growthlayer/pinball-arcade-controller/docs/cover_placement.png

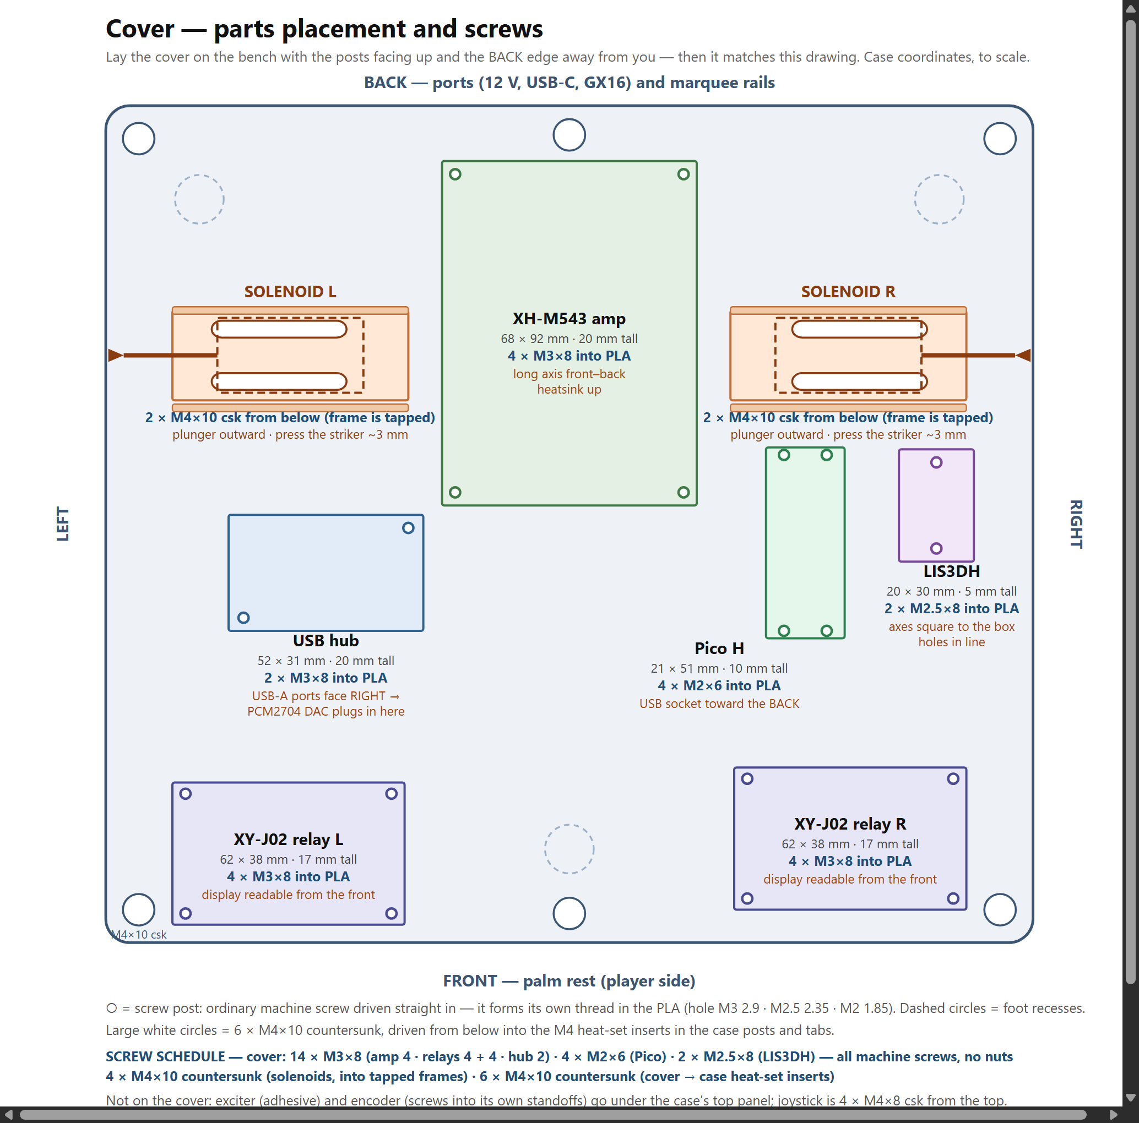
docs/cover_placement.png
