growthlayer/pinball-arcade-controller/docs/gx16_face_key_bottom.png

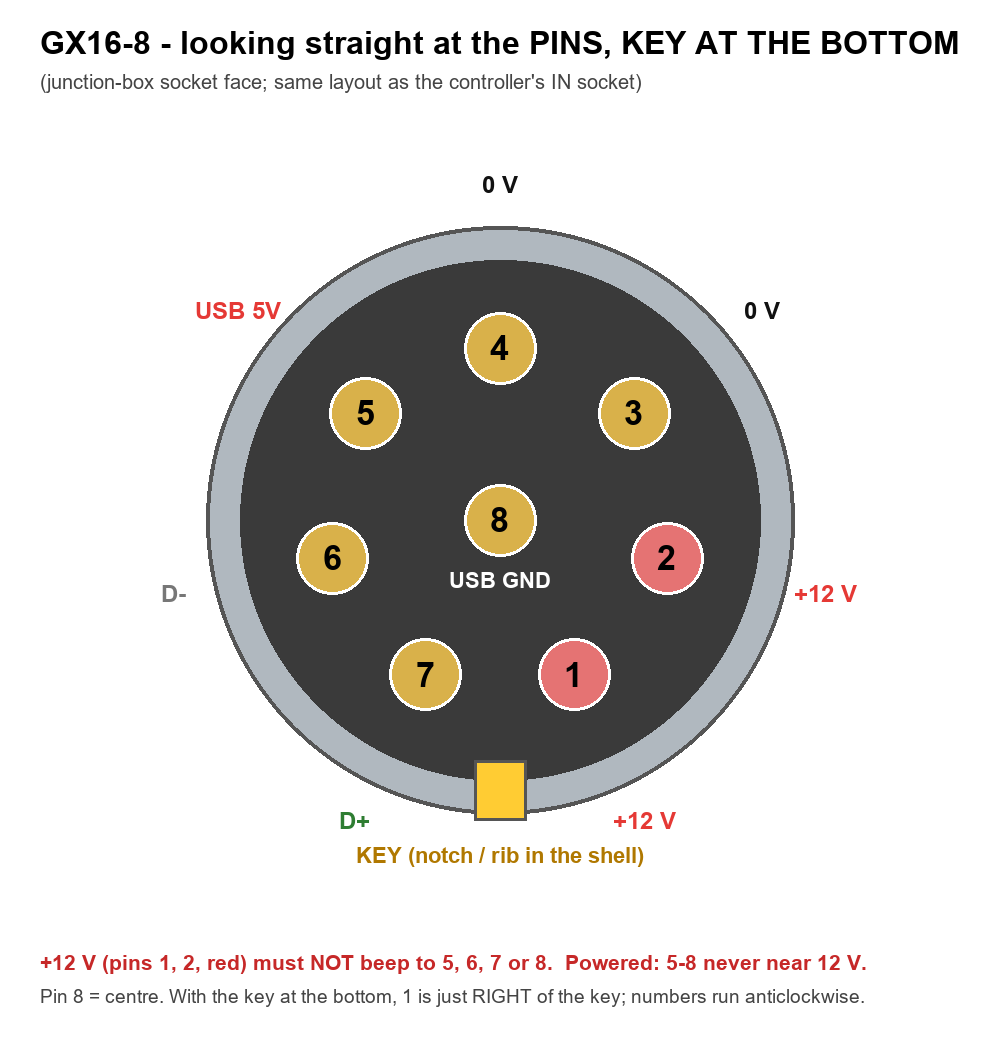
docs/gx16_face_key_bottom.png
