growthlayer/pinball-arcade-controller/docs/marquee_layout.png

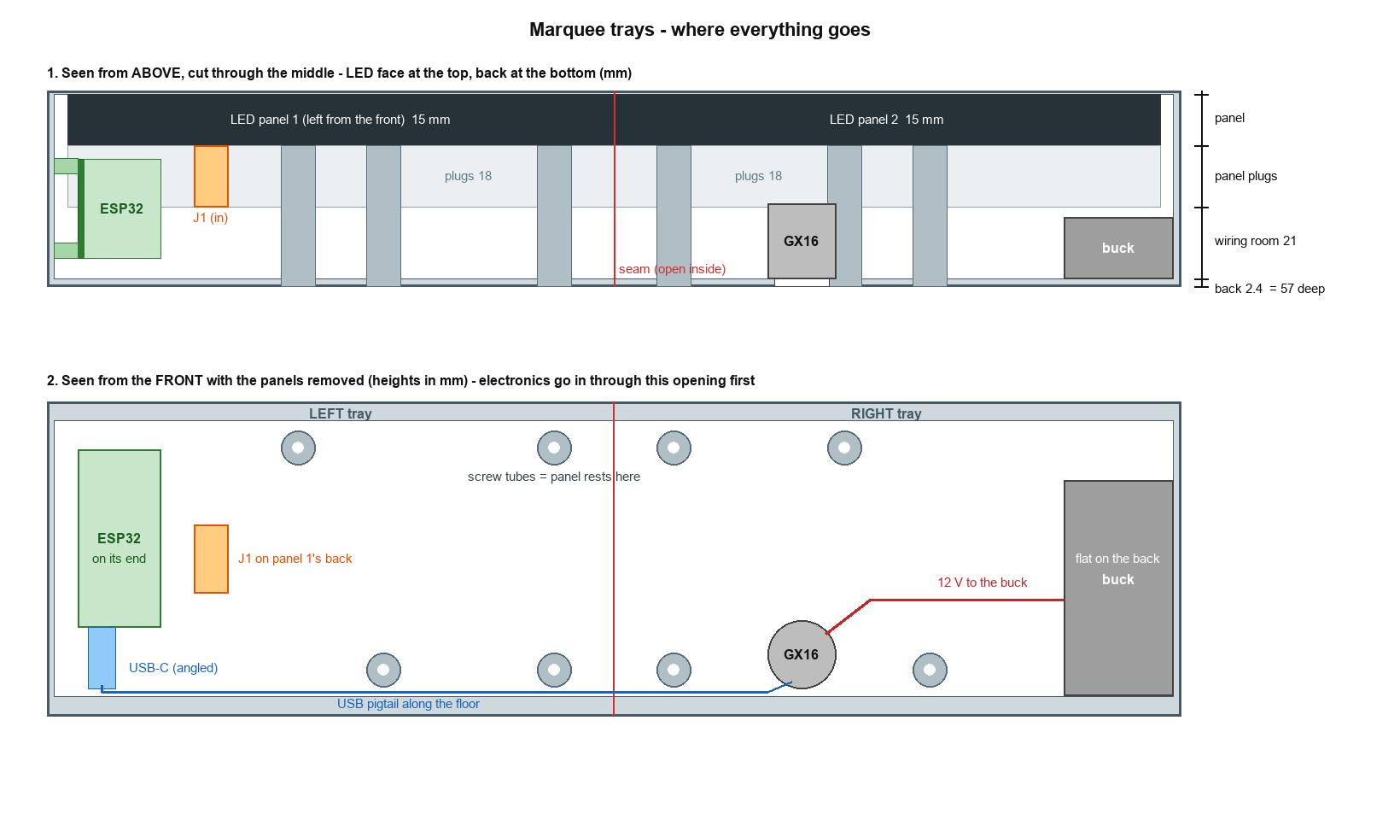
docs/marquee_layout.png
