growthlayer/pinball-arcade-controller/docs/pinouts/amp_xhm543.png

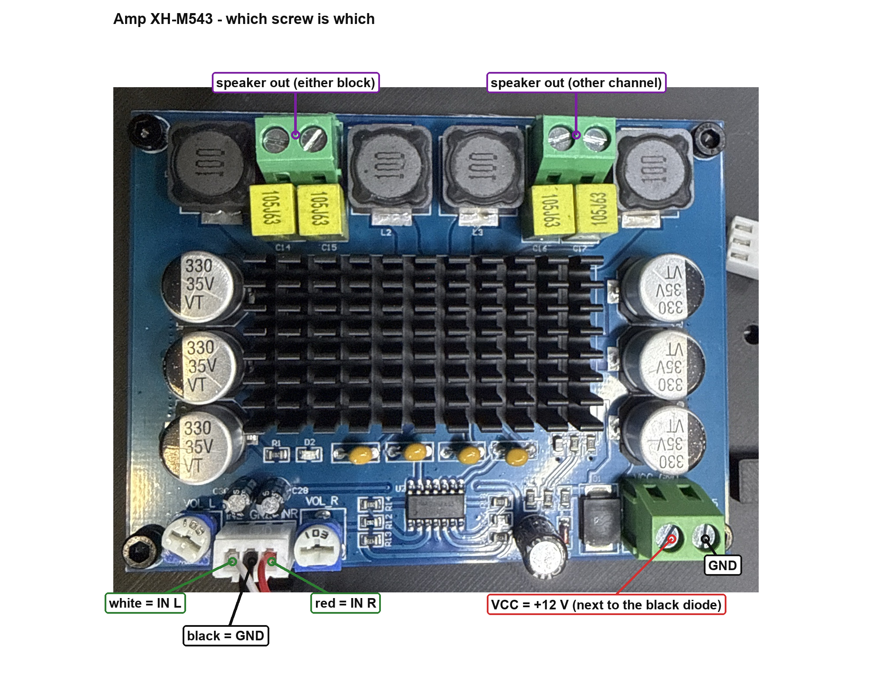
docs/pinouts/amp_xhm543.png
