growthlayer/pinball-arcade-controller/docs/pinouts/relay_xyj02.png

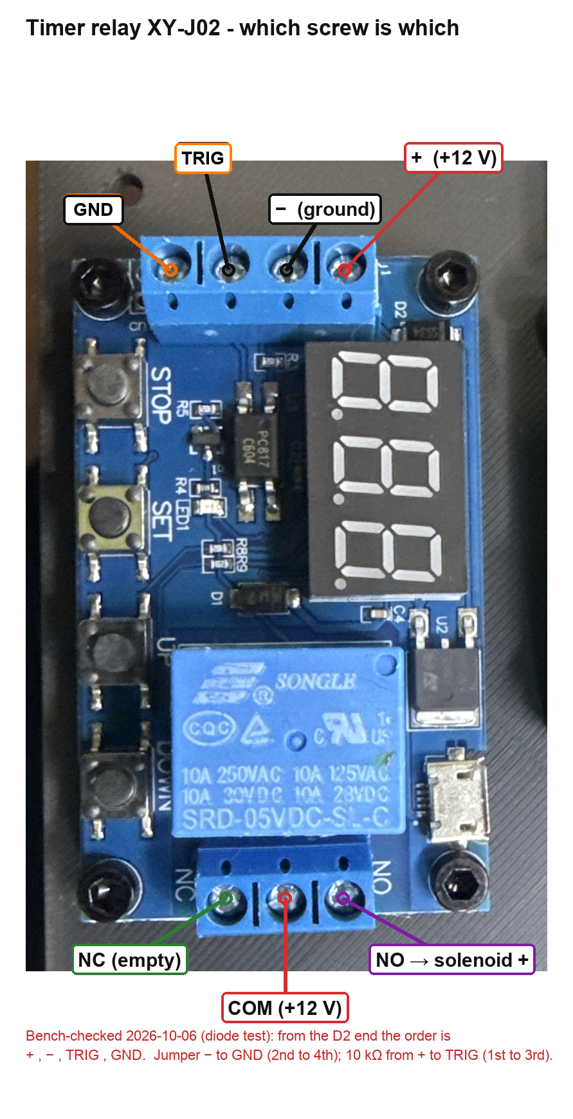
docs/pinouts/relay_xyj02.png
