growthlayer/pinball-arcade-controller/docs/renders/marquee_plate_screws.png

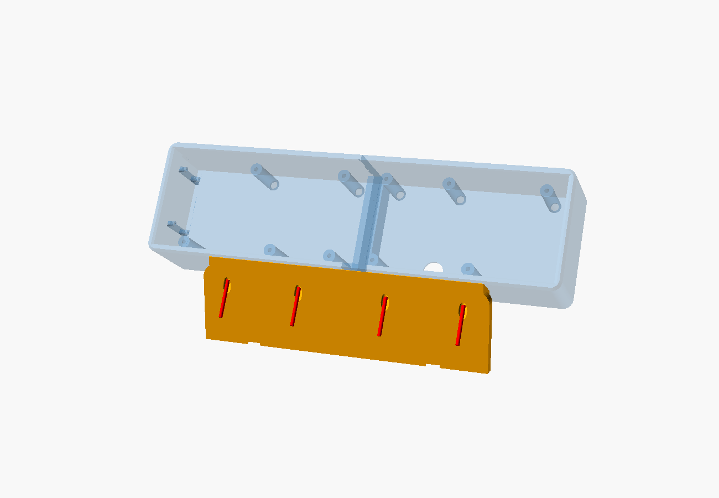
docs/renders/marquee_plate_screws.png
