growthlayer/pinball-arcade-controller/docs/renders/marquee_trays_inside.png

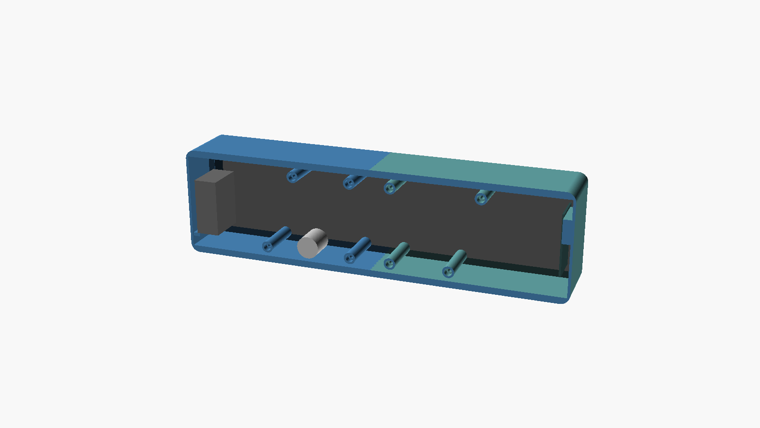
docs/renders/marquee_trays_inside.png
