growthlayer/pinball-arcade-controller/docs/routing_case.png

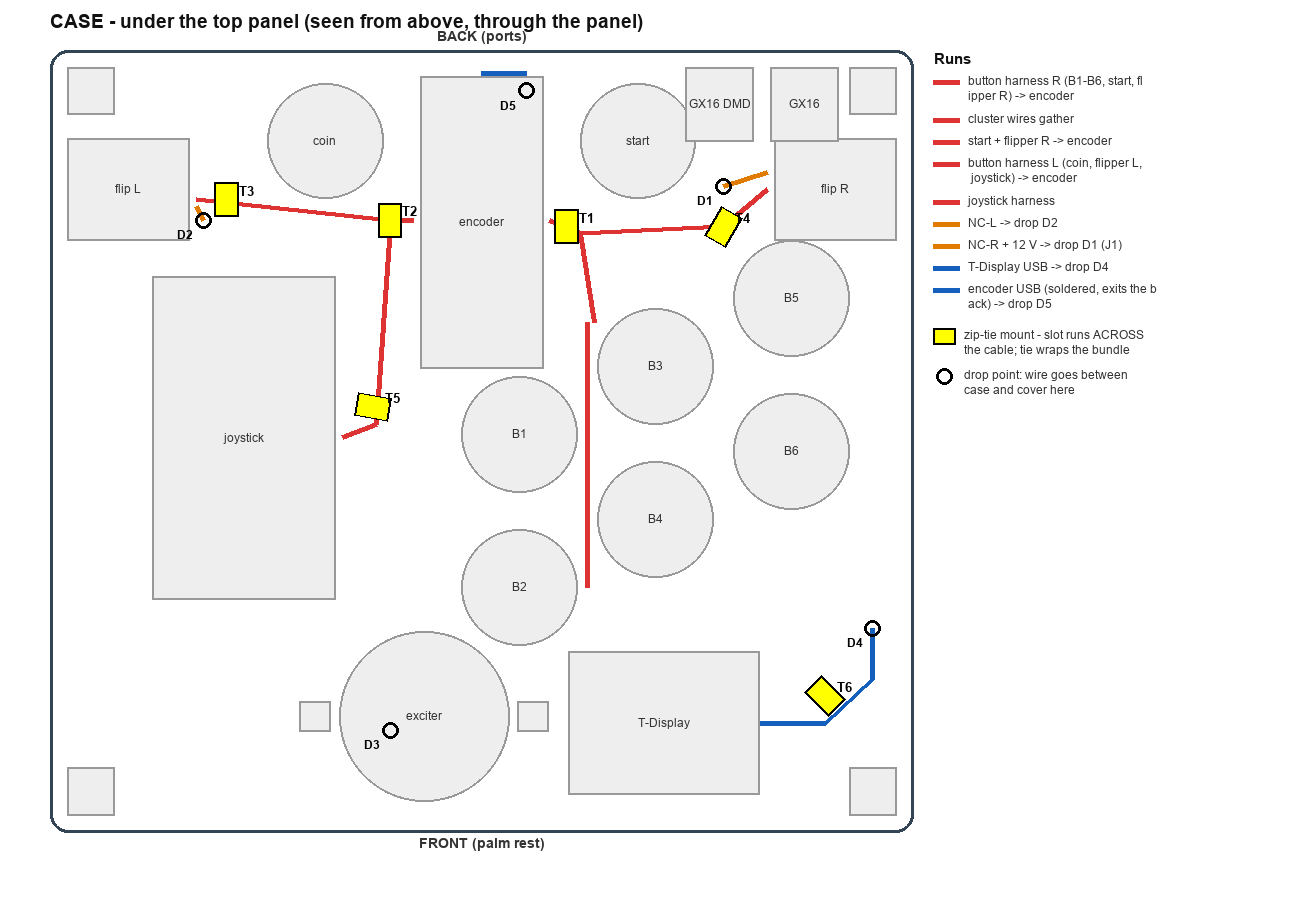
docs/routing_case.png
