growthlayer/pinball-arcade-controller/docs/routing_cover.png

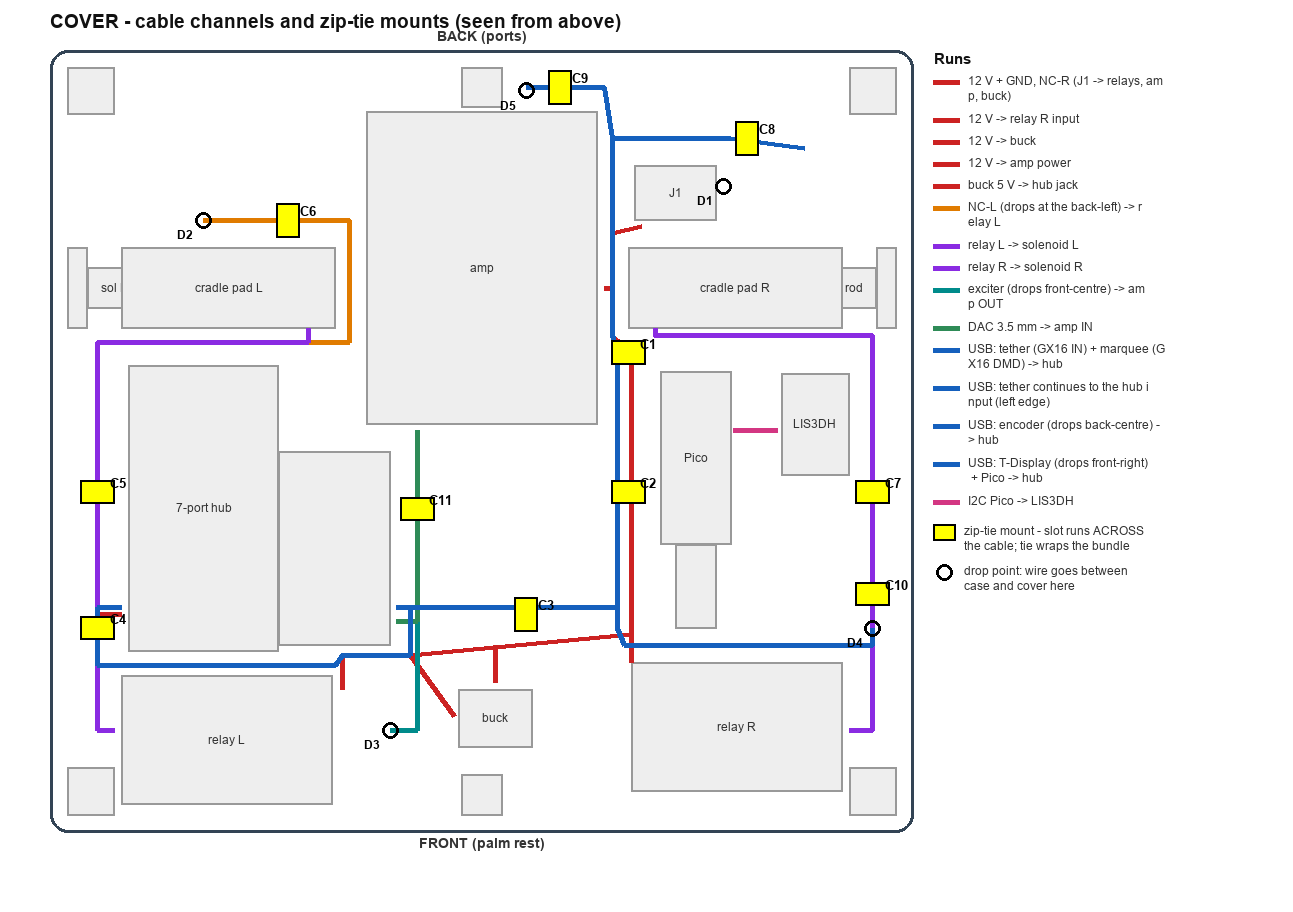
docs/routing_cover.png
