growthlayer/pinball-arcade-controller/images/part_case.png

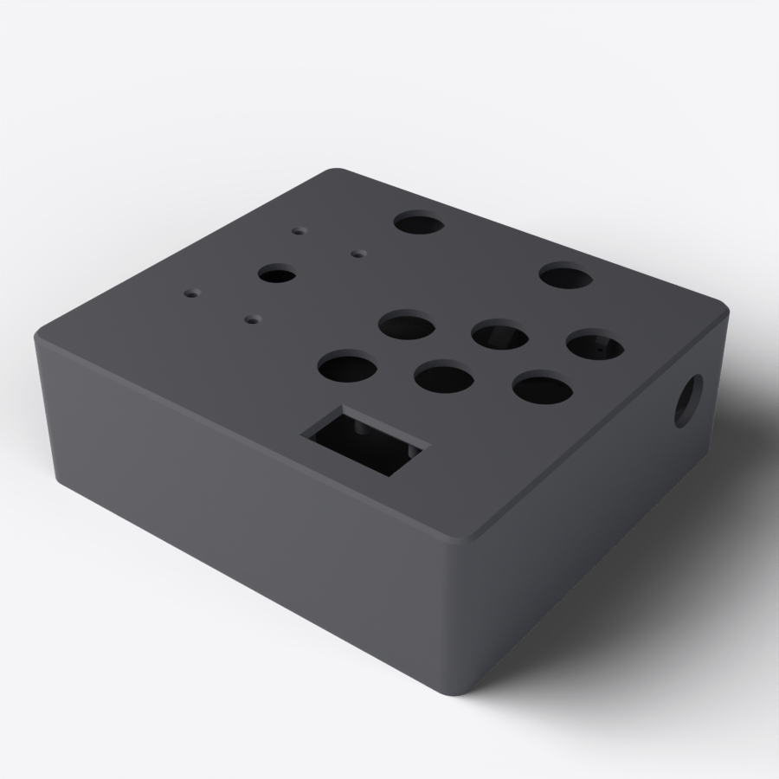
images/part_case.png
