growthlayer/pinball-arcade-controller/images/part_cover.png

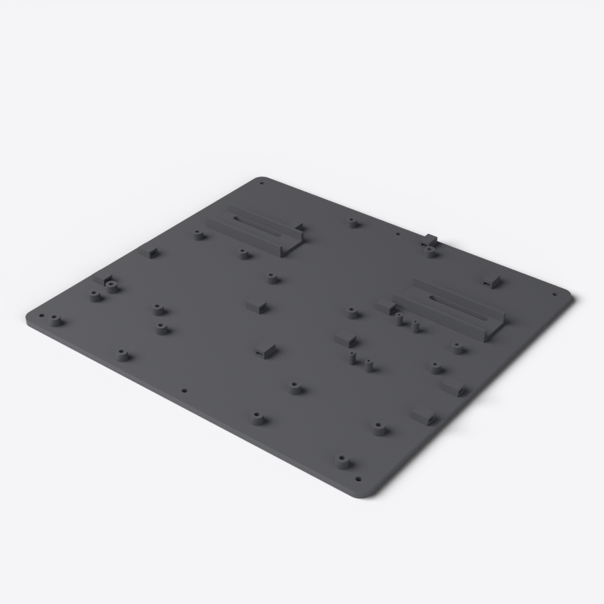
images/part_cover.png
