growthlayer/pinball-arcade-controller/print/bambu-a1/case.3mf

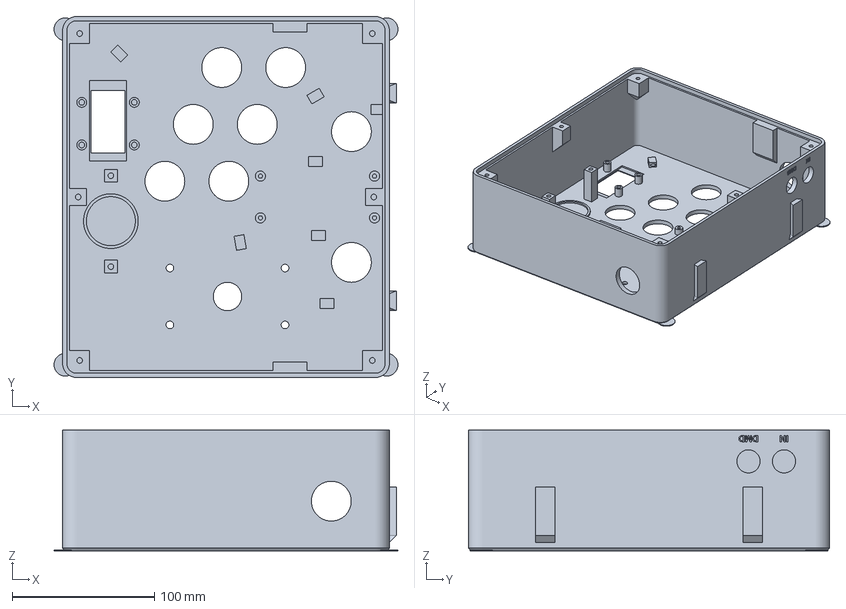
[picture p41: CAD file, 2026-10-13]
print/bambu-a1/case.3mf
242.0 x 254.0 x 85.0 mm
