growthlayer/pinball-arcade-controller/print/bambu-p1s/small_parts.3mf

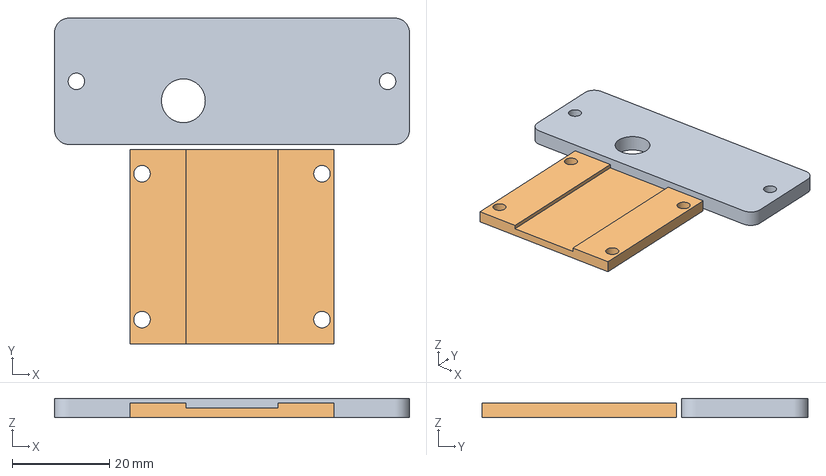
[picture p42: CAD file, 2026-10-13]
print/bambu-p1s/small_parts.3mf
73.0 x 67.0 x 4.00 mm
exciter_bridge.stl
td_clamp.stl
