growthlayer/pinball-arcade-controller/print/bambu-x1c/marquee_plate.3mf

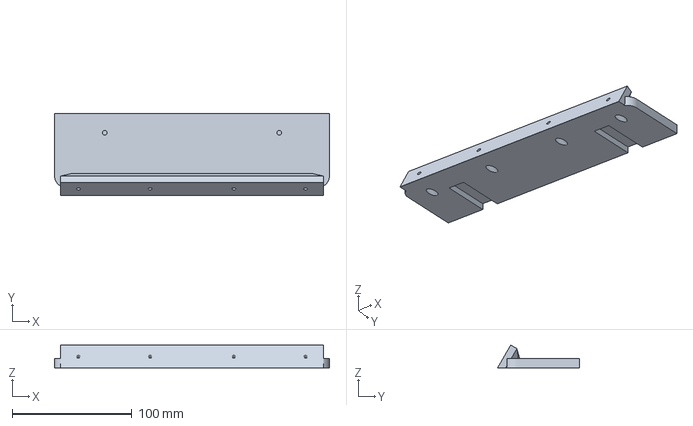
[picture p43: CAD file, 2026-10-13]
print/bambu-x1c/marquee_plate.3mf
230.0 x 68.5 x 19.2 mm
