growthlayer/pinball-arcade-controller/print/stl/exciter_bridge.stl

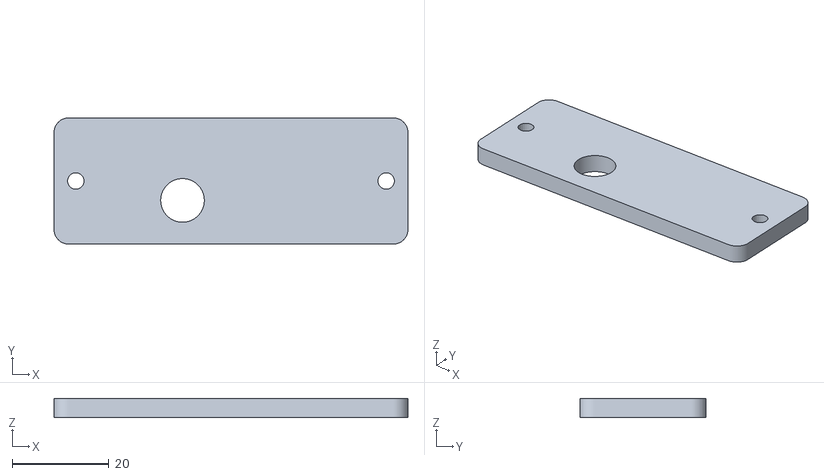
[picture p44: CAD file, 2026-10-13]
print/stl/exciter_bridge.stl
73.0 x 26.0 x 4.00
