growthlayer/pinball-arcade-controller/print/bambu-a1/small_parts.3mf

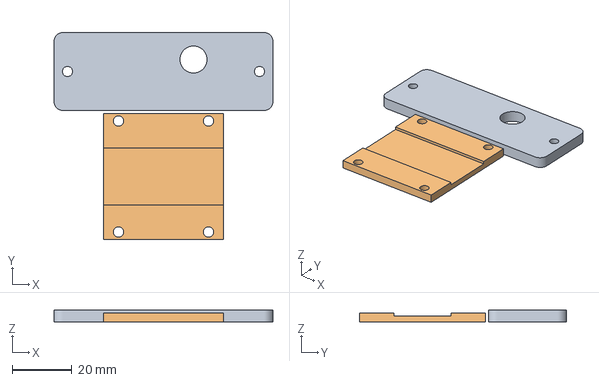
[picture p45: CAD file, 2026-10-13]
print/bambu-a1/small_parts.3mf
73.0 x 69.0 x 4.00 mm
exciter_bridge.stl
td_clamp.stl
