growthlayer/pinball-arcade-controller/print/bambu-p1s/test_prints.3mf

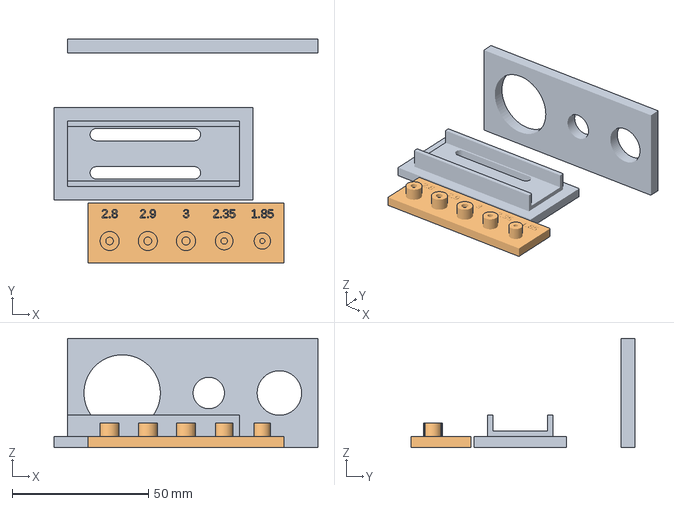
[picture p46: CAD file, 2026-10-13]
print/bambu-p1s/test_prints.3mf
96.8 x 82.0 x 40.0 mm
test_fit.stl
screw_test.stl
