growthlayer/pinball-arcade-controller/print/bambu-x1c/cover.3mf

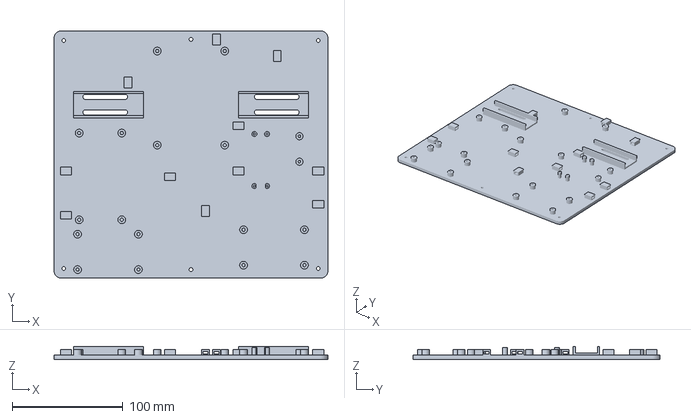
[picture p47: CAD file, 2026-10-13]
print/bambu-x1c/cover.3mf
247.6 x 223.6 x 12.0 mm
