growthlayer/pinball-arcade-controller/print/bambu-a1/marquee_trays.3mf

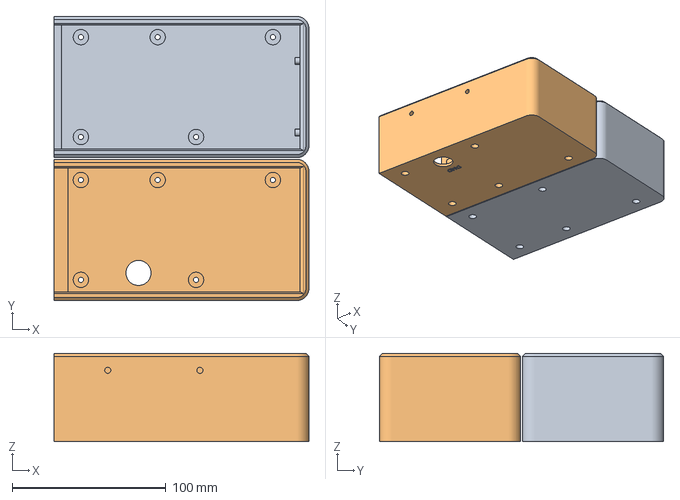
[picture p49: CAD file, 2026-10-13]
print/bambu-a1/marquee_trays.3mf
166.0 x 185.0 x 57.4 mm
marquee_tray_left.stl
marquee_tray_right.stl
