growthlayer/pinball-arcade-controller/print/bambu-a1/marquee_plate.3mf

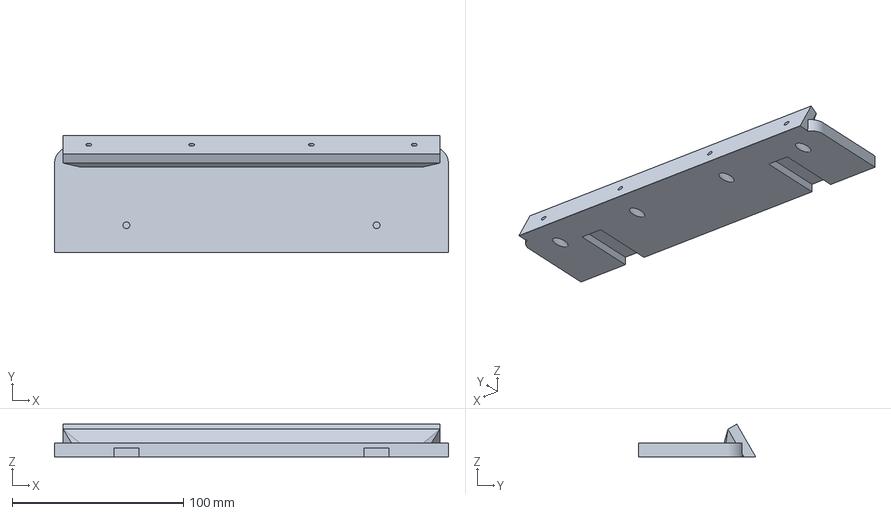
[picture p50: CAD file, 2026-10-13]
print/bambu-a1/marquee_plate.3mf
230.0 x 68.5 x 19.2 mm
