growthlayer/pinball-arcade-controller/print/stl/marquee_tray_right.stl

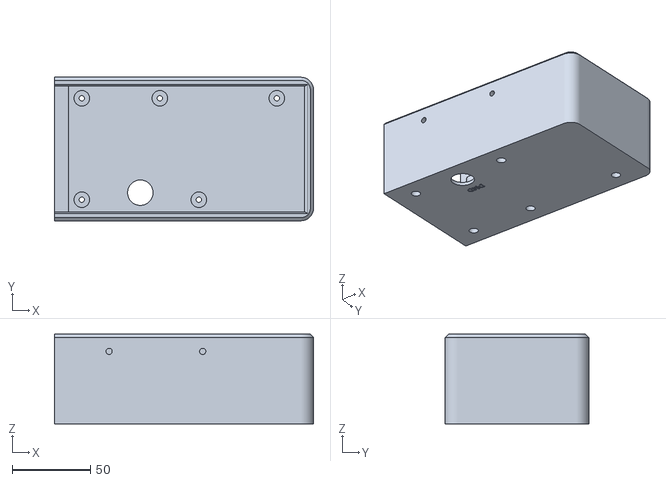
[picture p51: CAD file, 2026-10-13]
print/stl/marquee_tray_right.stl
166.0 x 92.0 x 57.4
