growthlayer/pinball-arcade-controller/print/stl/test_fit.stl

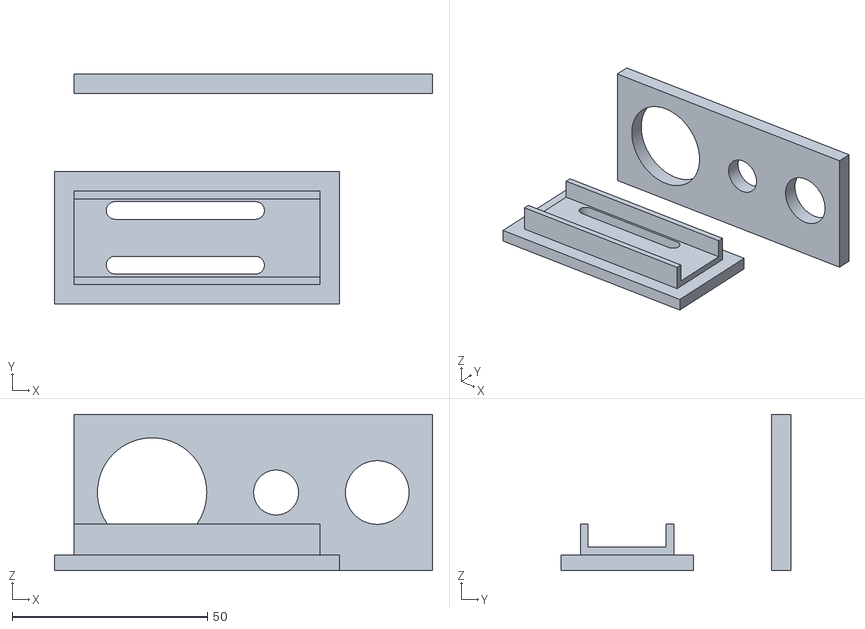
[picture p52: CAD file, 2026-10-13]
print/stl/test_fit.stl
96.8 x 59.0 x 40.0
