growthlayer/pinball-arcade-controller/print/stl/td_clamp.stl

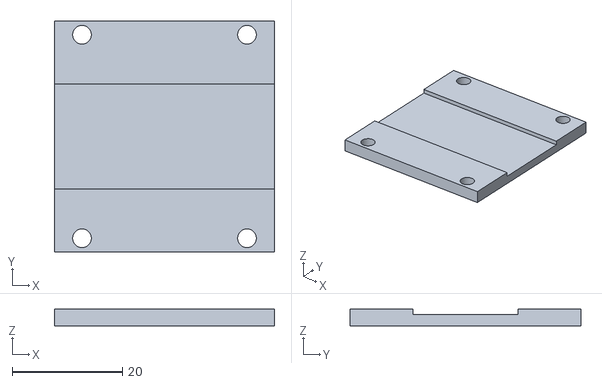
[picture p53: CAD file, 2026-10-13]
print/stl/td_clamp.stl
40.0 x 42.0 x 3.00
