growthlayer/pinball-arcade-controller/model/tie_points.scad

// GENERATED by docs/cable_router.py - do not edit by hand. [x, y, cable direction deg] in case coords
tie_cover = [[170, 141, 90], [170, 100, 90], [140, 64, 0], [14, 60, 90], [14, 100, 90], [70, 180, 0], [242, 100, 90], [205, 204, 0], [150, 219, 0], [242, 70, 90], [108, 95, 90]];
tie_case  = [[152, 178, 180], [100, 180, 0], [52, 186, 0], [198, 178, 150], [95, 125, 80], [228, 40, 45]];
