growthlayer/pinball-arcade-controller/(list of files, cad)

Other CAD files:
print/bambu-a1/cover.3mf
print/bambu-p1s/marquee_plate.3mf
print/bambu-x1c/small_parts.3mf
print/bambu-p1s/marquee_trays.3mf
print/bambu-x1c/case.3mf
print/stl/case.stl
print/bambu-p1s/cover.3mf
print/bambu-x1c/marquee_trays.3mf
print/stl/cover.stl
print/bambu-a1/test_prints.3mf
print/bambu-p1s/case.3mf
print/bambu-x1c/test_prints.3mf
print/stl/marquee_plate.stl
print/stl/screw_test.stl
