growthlayer/pinball-arcade-controller/docs/gx16_case_solder.png

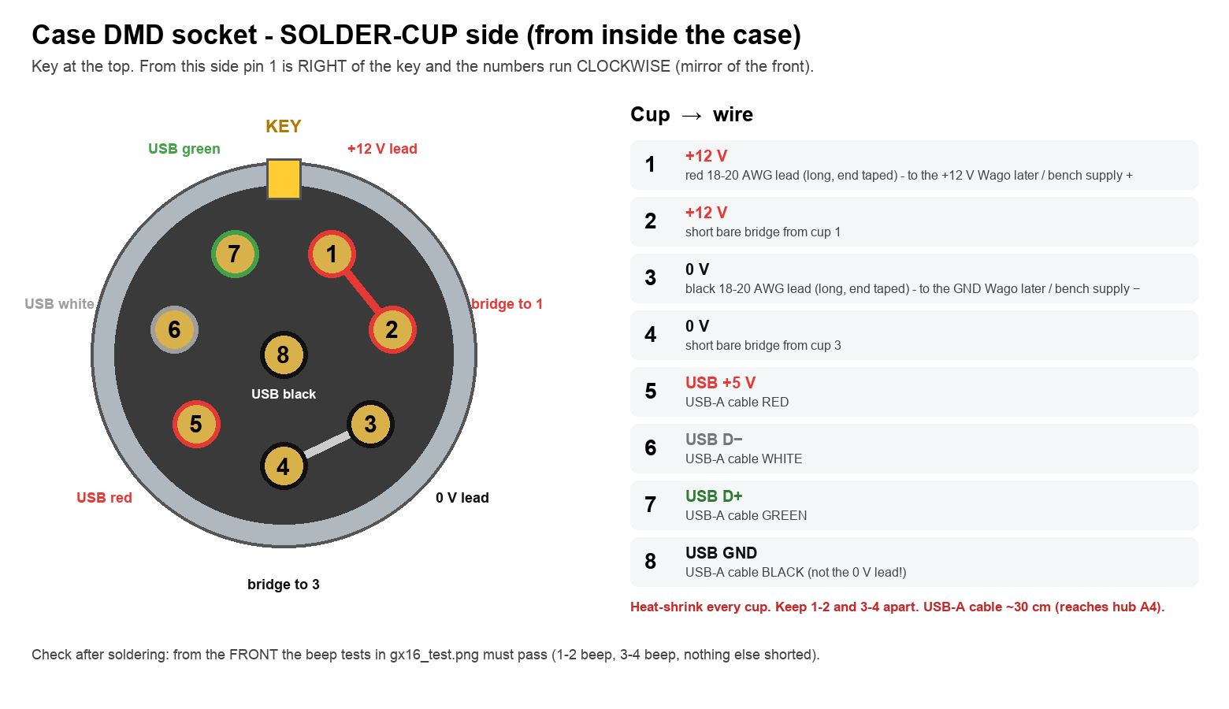
docs/gx16_case_solder.png
