growthlayer/pinball-arcade-controller/docs/gx16_box_test.png

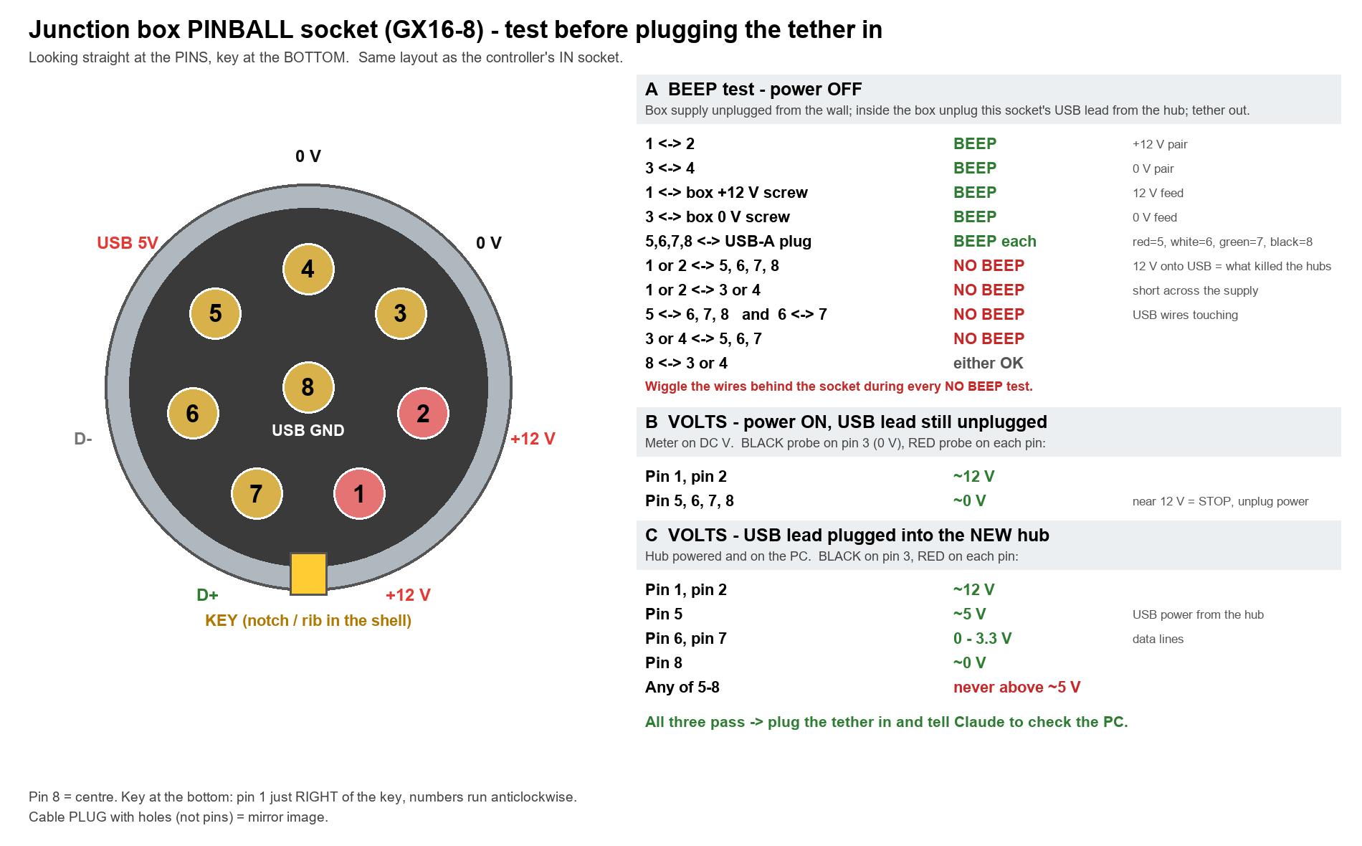
docs/gx16_box_test.png
