growthlayer/pinball-arcade-controller/docs/gx16_test.png

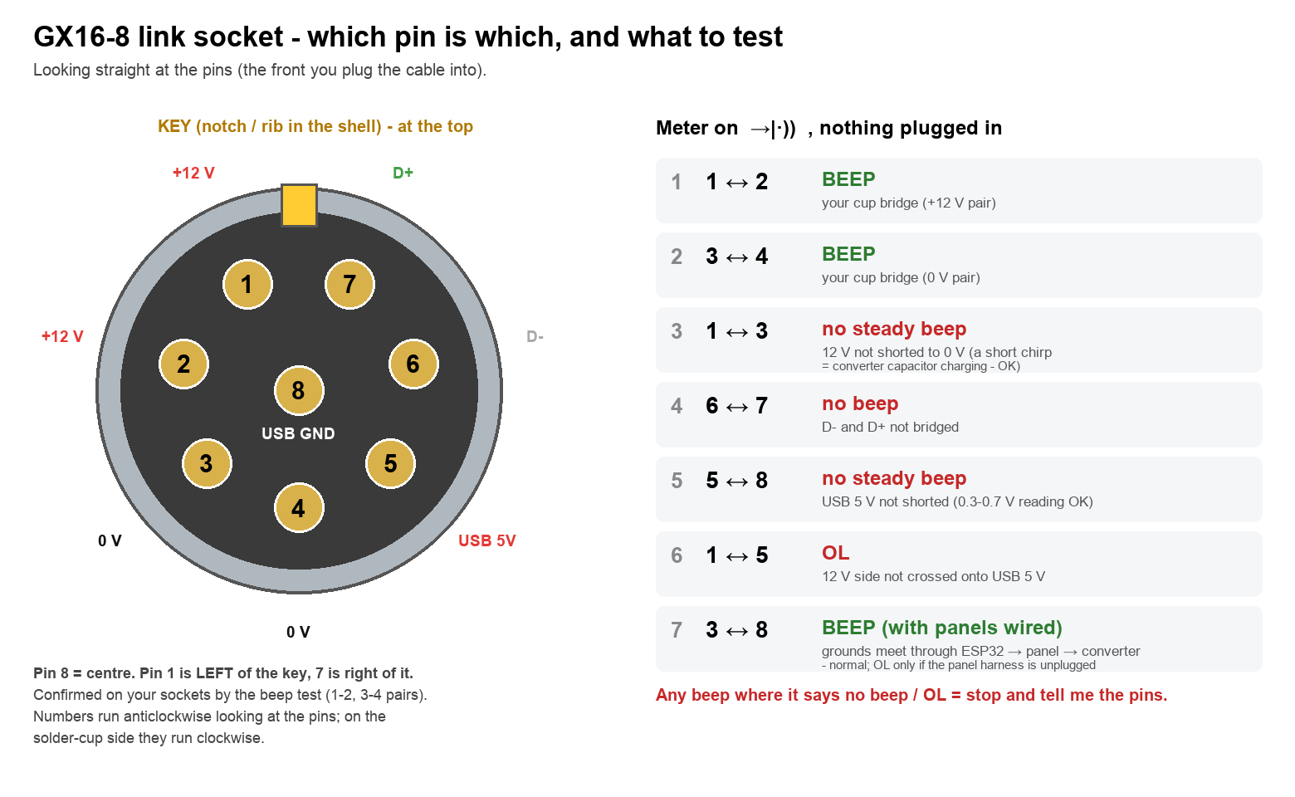
docs/gx16_test.png
