growthlayer/pinball-arcade-controller/docs/usb_tether_test.png

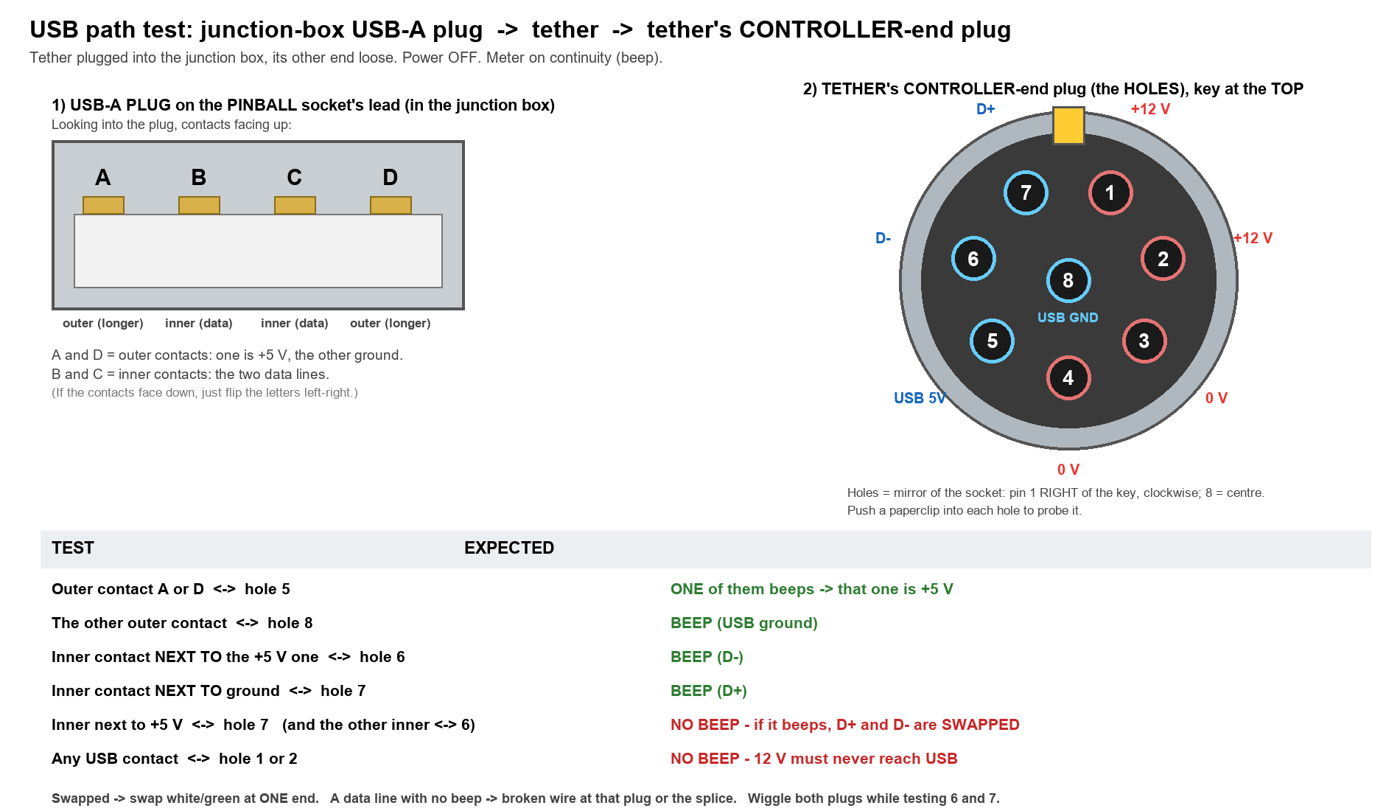
docs/usb_tether_test.png
