growthlayer/pinball-arcade-controller/(commit log)

2026-10-13 Pinball arcade controller: desktop virtual-pinball + arcade controller with solenoid knock, haptics, nudge and LED marquee
    Build guide, parts list, step-by-step wiring pictures, Blender renders, ready-to-print Bambu Studio
    projects (A1 / P1S / X1C) and STLs, parametric OpenSCAD model, firmware configs and patches, PC helpers.
    [case.3mf, case.stl, cover.3mf, cover.stl, exciter_bridge.stl, marquee_plate.3mf, marquee_plate.stl, marquee_tray_left.stl]
2026-10-13 Marquee service: recover a ZeDMD that stops answering by resetting the ESP32
    [marquee_service.py]
2026-10-13 Marquee offline show: neon synthwave NO SIGNAL / WAITING FOR PC built into the ESP32
    Replaces the ZeDMD attract show with a pre-rendered show that says the PC isn't connected, in the same style
    as the PC-driven neon show. tools/synthwave/offline.py draws it; make_offline_firmware.py compresses it into
    firmware/attract_offline.h (ZeDMD inflates it with its own miniz).
    [make_offline_firmware.py, offline.py]
2026-10-15 Termination-box notes, separate DC + USB option, exciter/marquee/status fixes
    - README: why the GX16 tether exists, the hub-in-the-box requirement at 480 Mbps,
    and the no-termination-box alternative (DC jack + USB cable)
    - Pinscape: velocity nudge on the slider axes, calibration values recorded
    - Exciter relay: mono fold, level knob, keeps Windows' default output on the room
    speakers (name from config.json)
    - Marquee service: one ESP32 reset per failure; all stream errors logged
    - Status host: releases a dead serial handle so the display reconnects
    [exciter_relay.py, marquee_service.py, pinball_status.py]
